IowaScaledEngineering/ckt-xing/mech/ckt-xing-basic-insert v9.stl

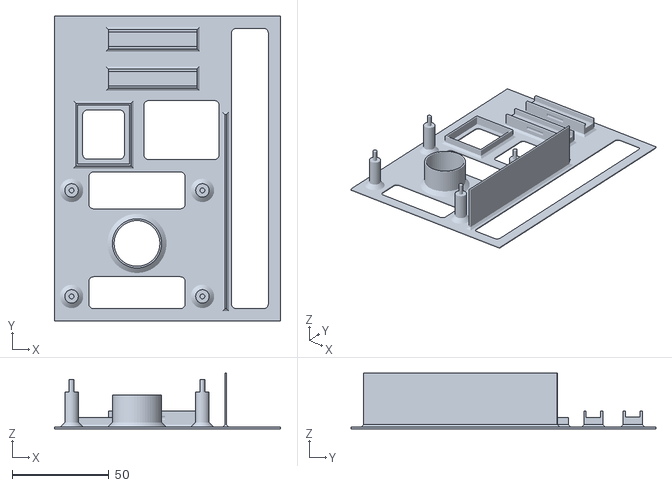
[picture p1: CAD file, 2024-09-25]
mech/ckt-xing-basic-insert v9.stl
116.8 x 157.5 x 28.8
