IowaScaledEngineering/ckt-xing/pg/ckt-xing-tester-v1.0-192aa89/ckt-xing-tester.pdf

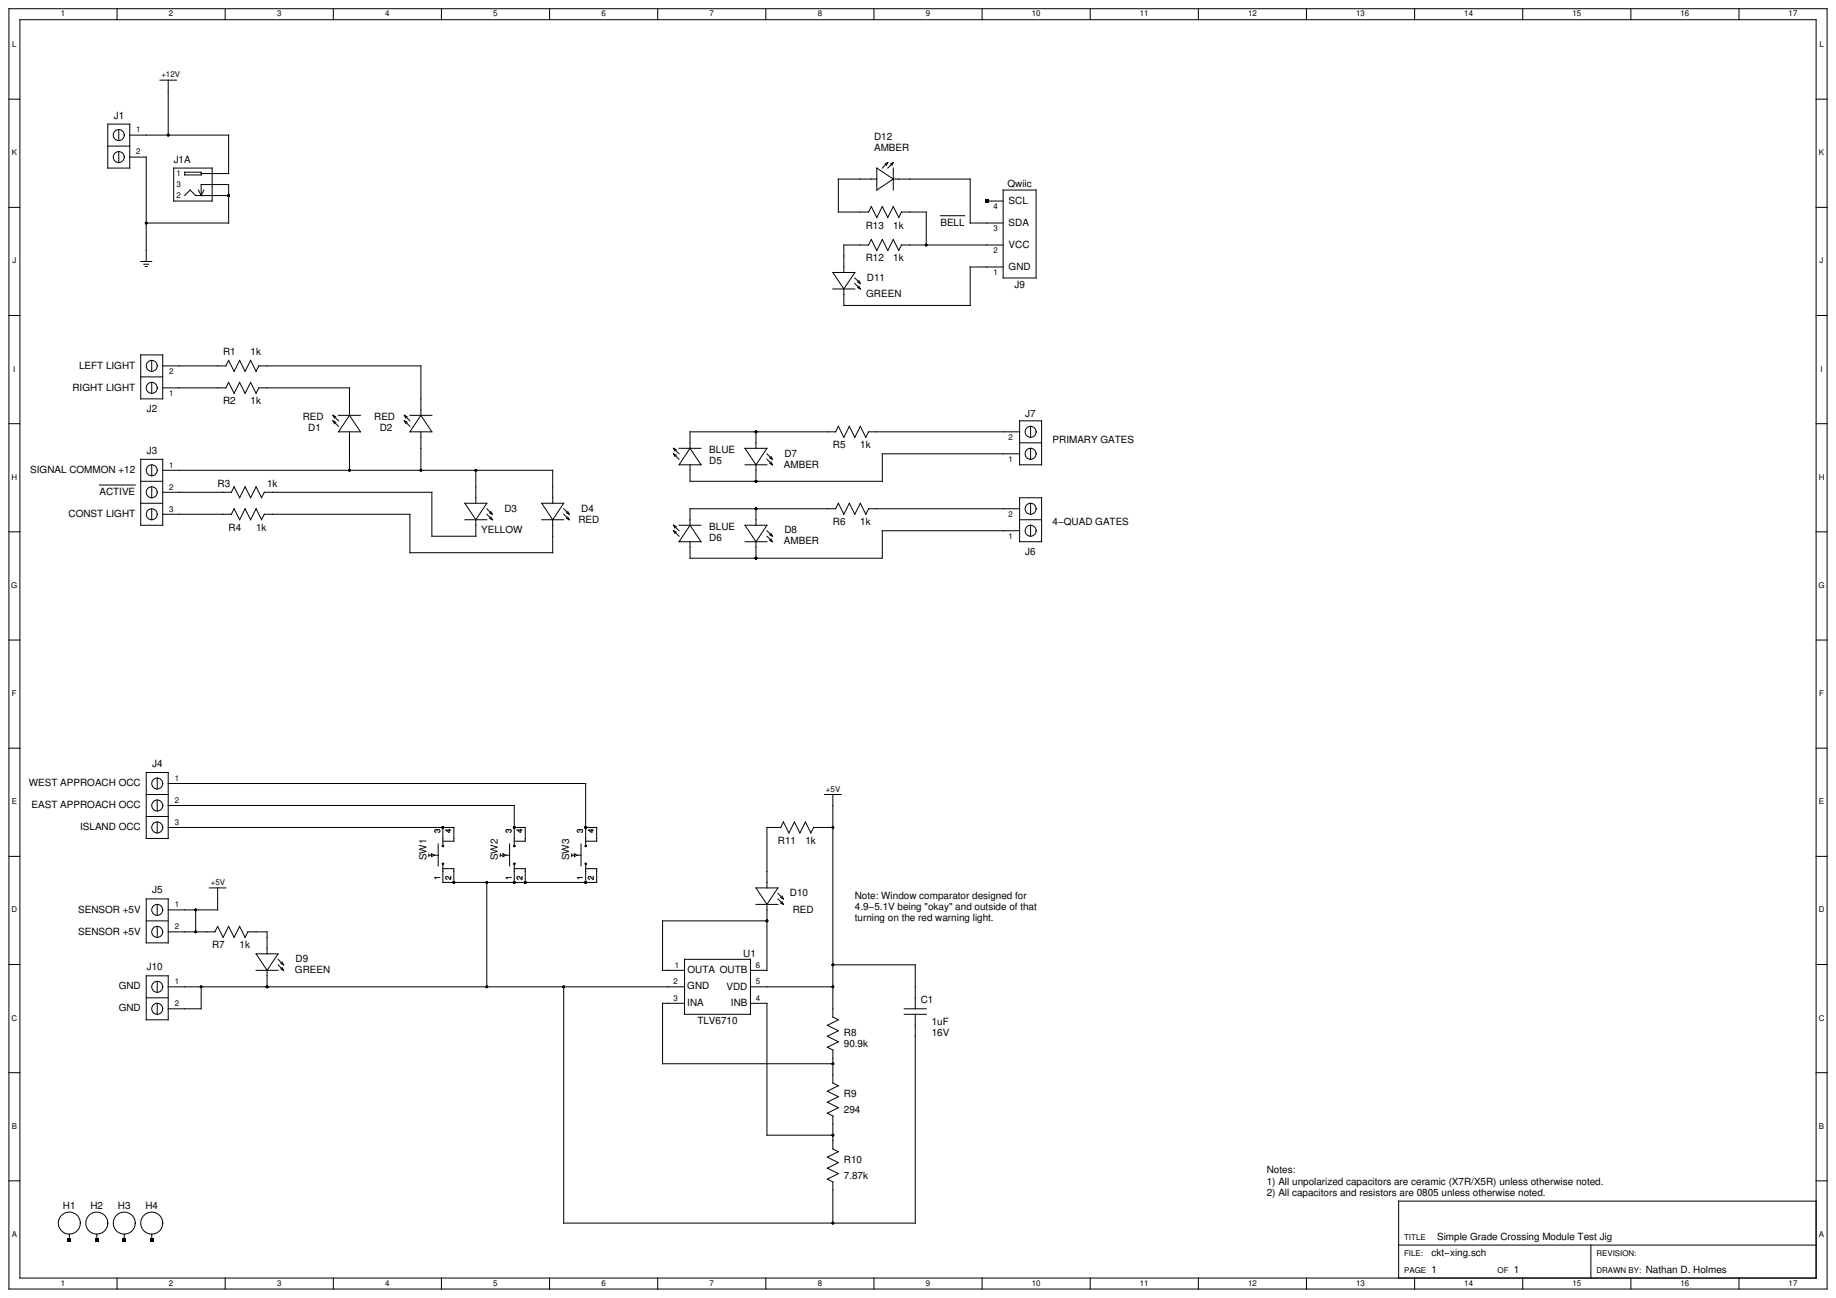
[picture p11: page 1]

Note: Window comparator designed for
4.9−5.1V being "okay" and outside of that
turning on the red warning light.

Notes:
1) All unpolarized capacitors are ceramic (X7R/X5R) unless otherwise noted.
2) All capacitors and resistors are 0805 unless otherwise noted.

Simple Grade Crossing Module Test Jig
ckt−xing.sch
