IowaScaledEngineering/ckt-xing/pg/ckt-xing-adv-v1.0-cd81ae9/ckt-xing-adv.pdf

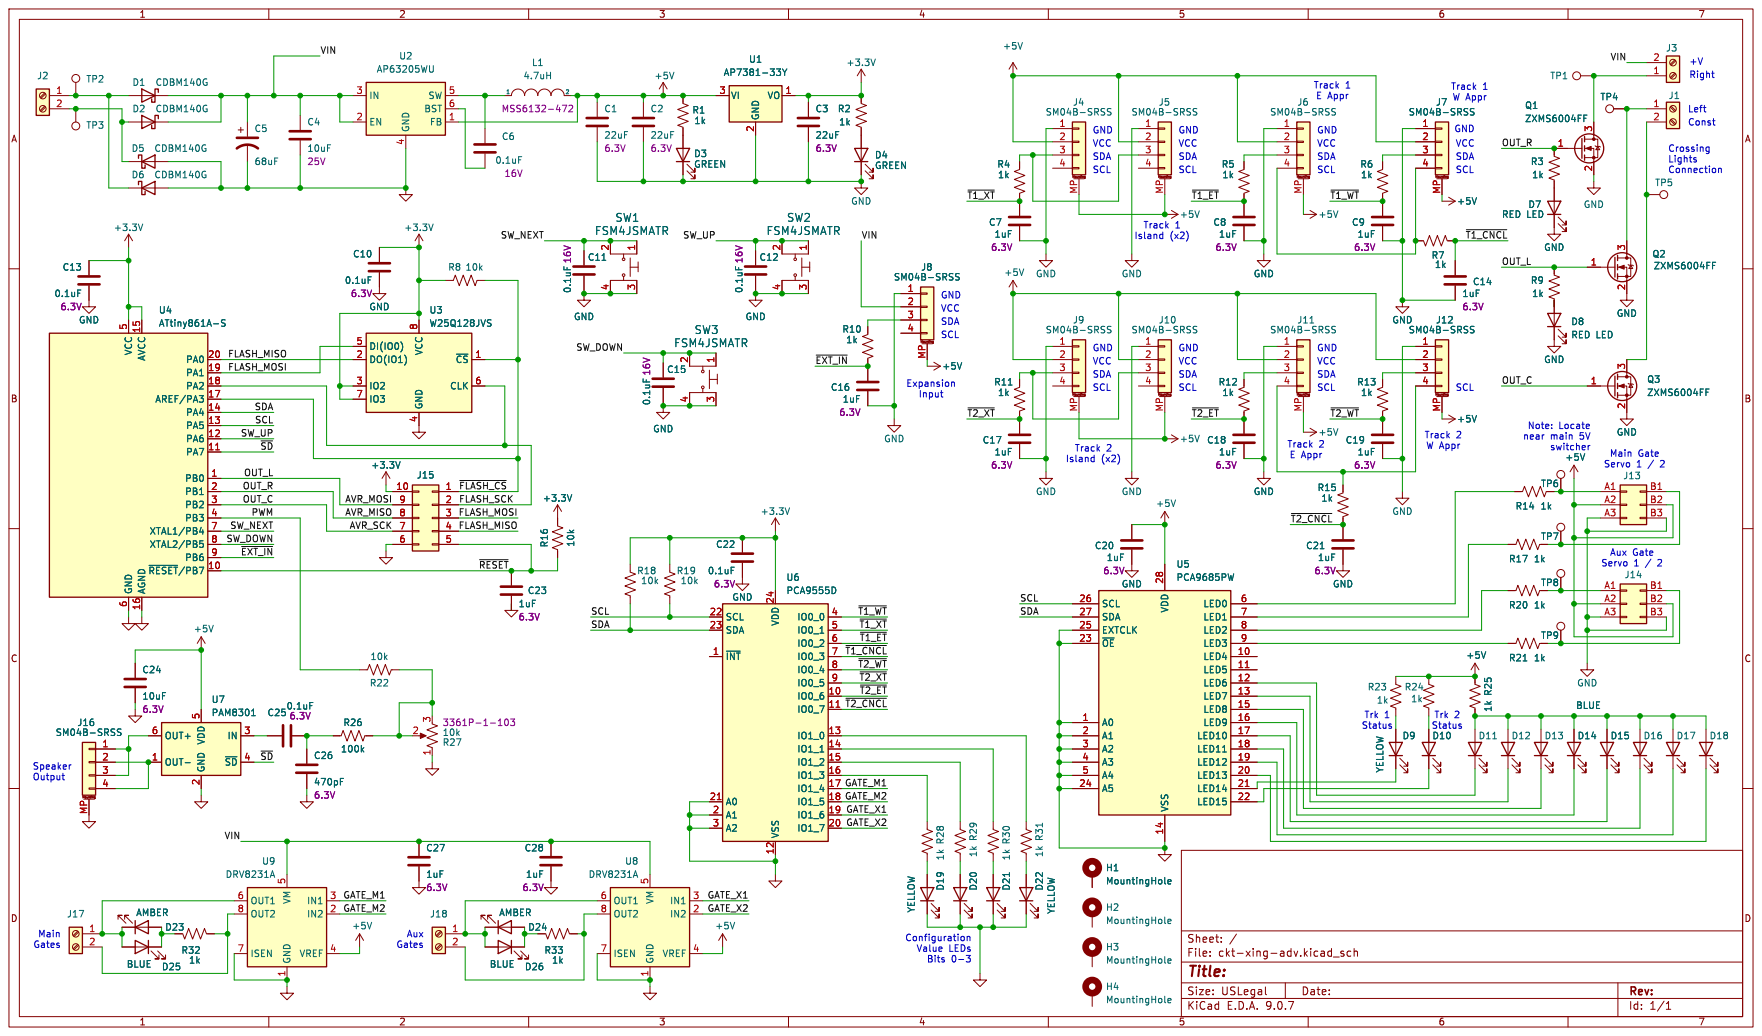
[picture p12: page 1]

Aux Gate Servo 1 / 2 SCL VCC

6 AVCC 15 AGND 16 PA0 20 PA1 19 PA2 18 AREF/PA3 17 PA4 14 PA5 13 PA6 12 PA7 11 PB0 1 PB1 2 PB2 3 PB3 4 XTAL1/PB4 7 XTAL2/PB5 8 PB6 9 ~{RESET}/PB710 U4ATtiny861A-S

Expansion
Trk 1 Status SCL Configuration Value LEDs Bits 0-3

Id: 1/1 Title: File: ckt-xing-adv.kicad_sch Sheet: /
