IowaScaledEngineering/ckt-xing/pg/ckt-xing-basic-v1.1-d01540c/ckt-xing-basic.pdf

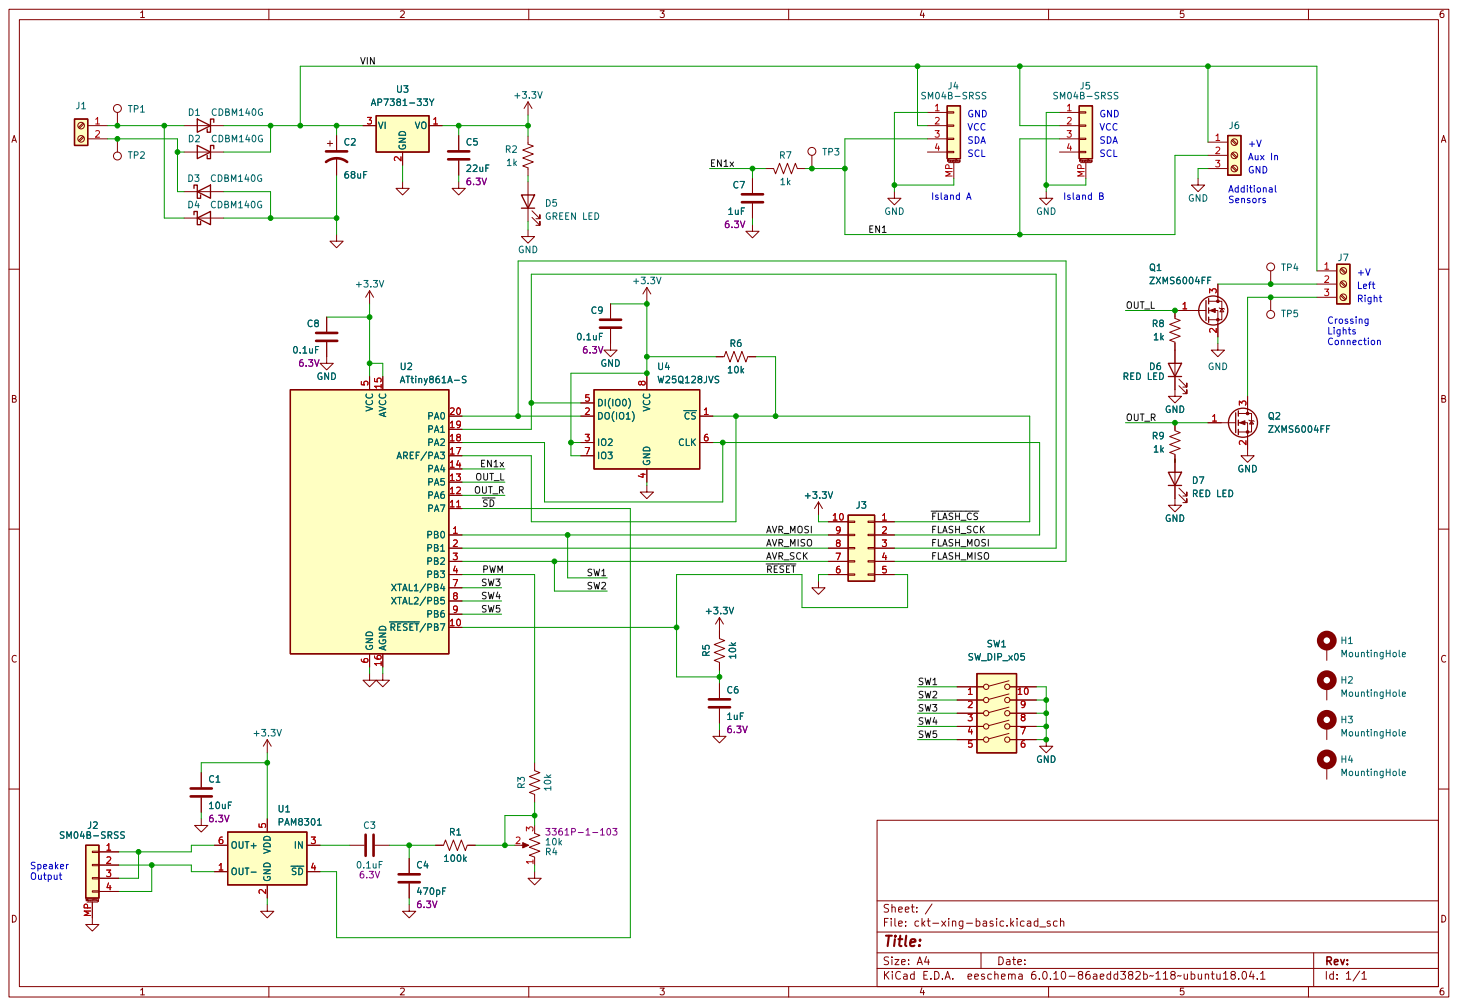
[picture p14: page 1]

AVR_MISO 8 8 | 3 3

PWM
