IowaScaledEngineering/ckt-xing/pg/ckt-xing-txm-v1.0-6521851/ckt-xing-txm.pdf

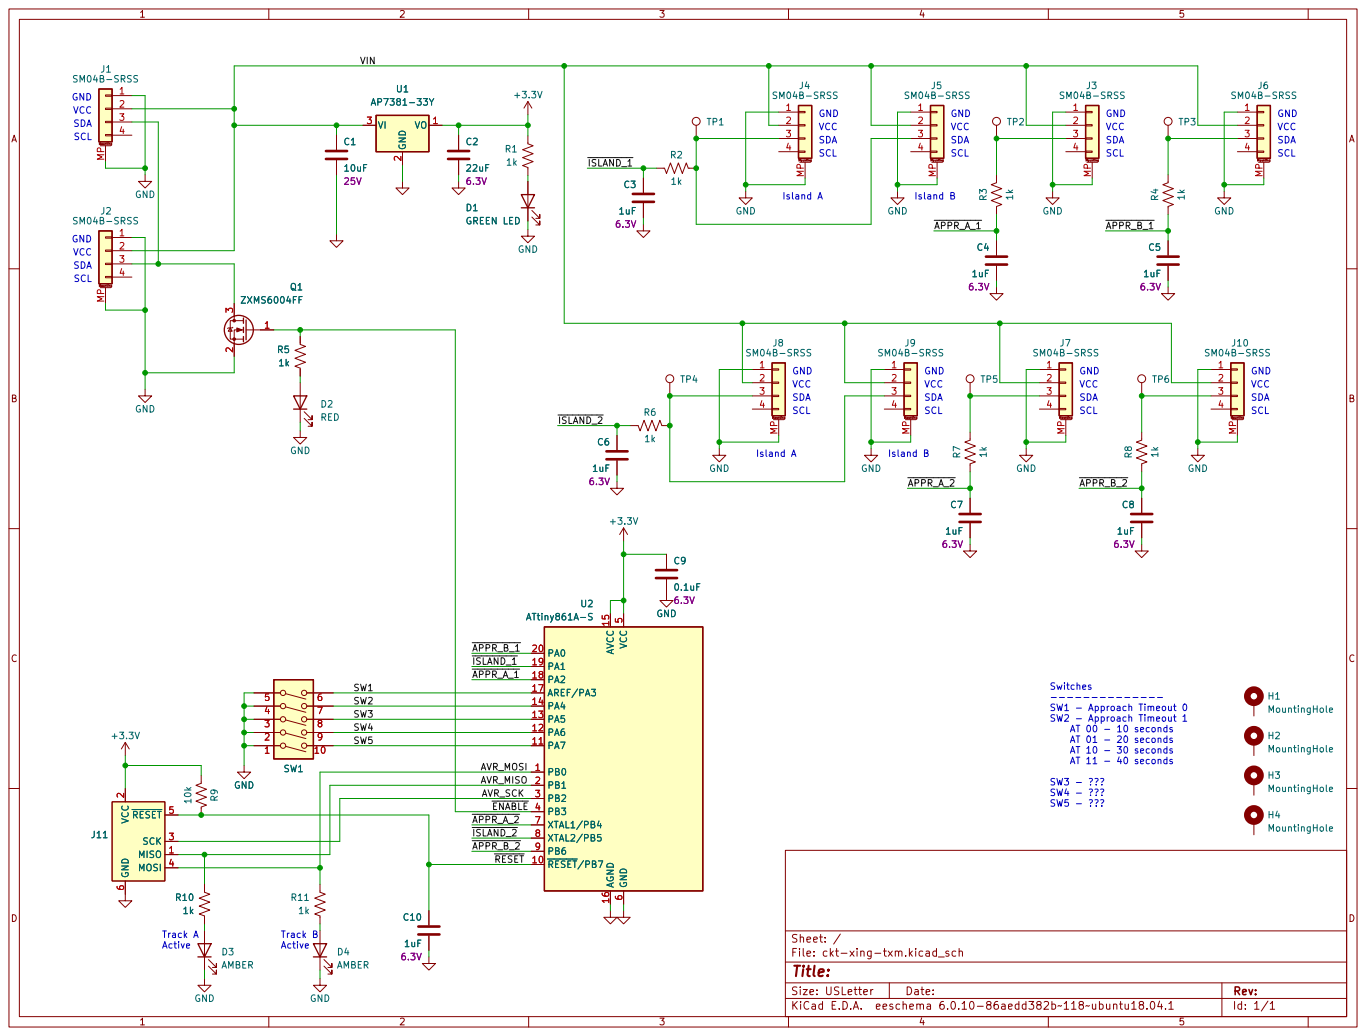
[picture p15: page 1]

2 SCK 3 MOSI 4 ~{RESET} 5 GND

File: ckt-xing-txm.kicad_sch Sheet: /
