IowaScaledEngineering/ckt-xing/pg/ckt-xing-v2.0-f107f7d/ckt-xing-pcb.pdf

# ckt-xing.pcb

# 1. Table of Contents (This Page) Created on Mon Jan 25 11:11:42 2021

# 2. component 3. solder 4. outline 5. plated-drill 6. componentmask 7. soldermask 8. topsilk 9. bottomsilk 10. toppaste 11. topassembly 12. bottomassembly 13. fab

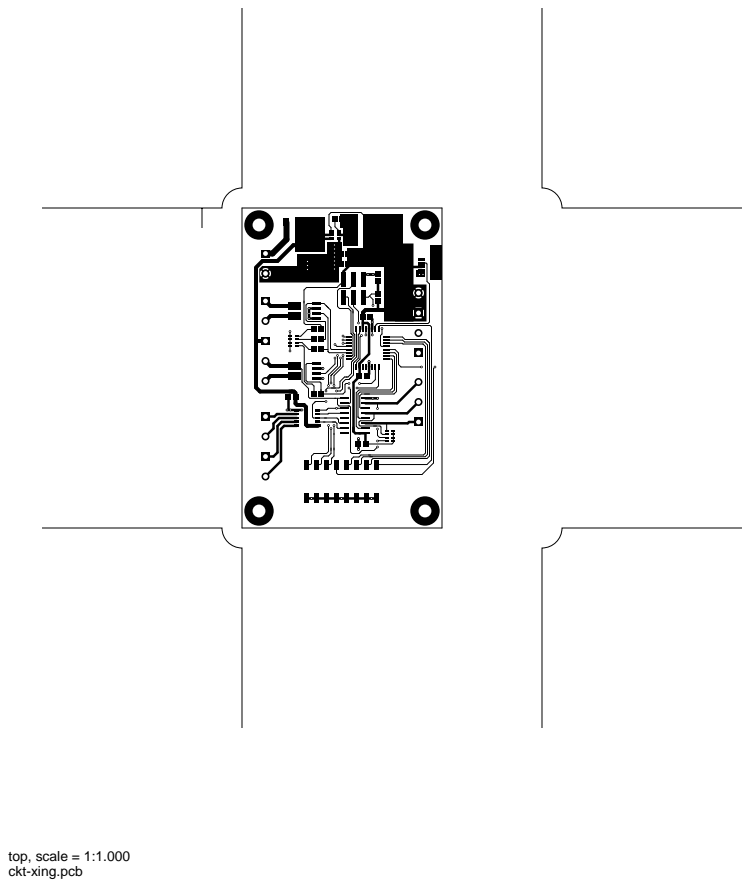
[picture p16: page 2]
top, scale = 1:1.000

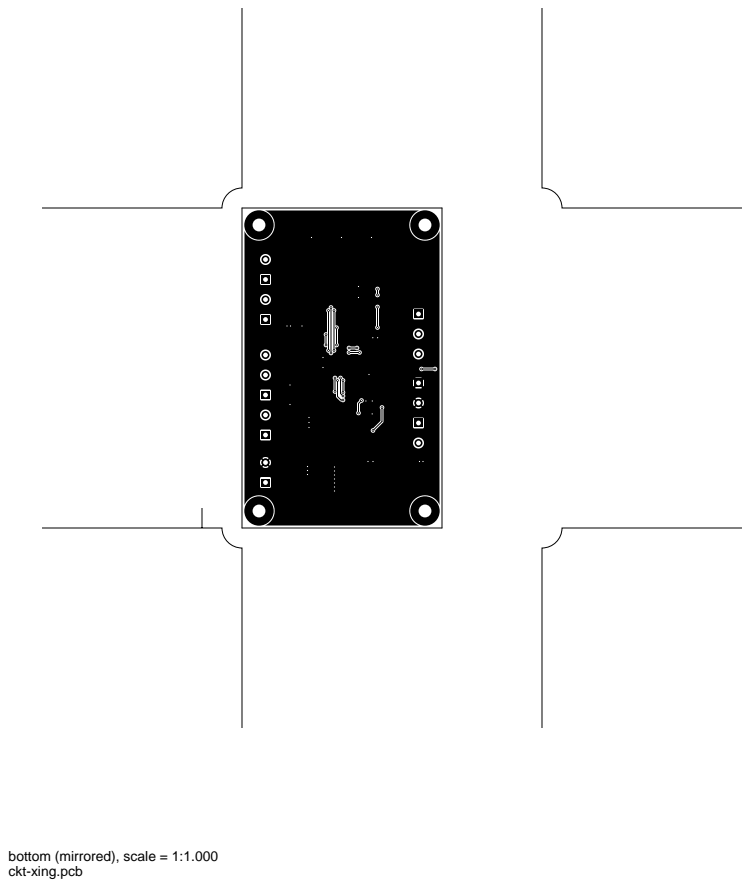
[picture p17: page 3]

bottom (mirrored), scale = 1:1.000

outline, scale = 1:1.000

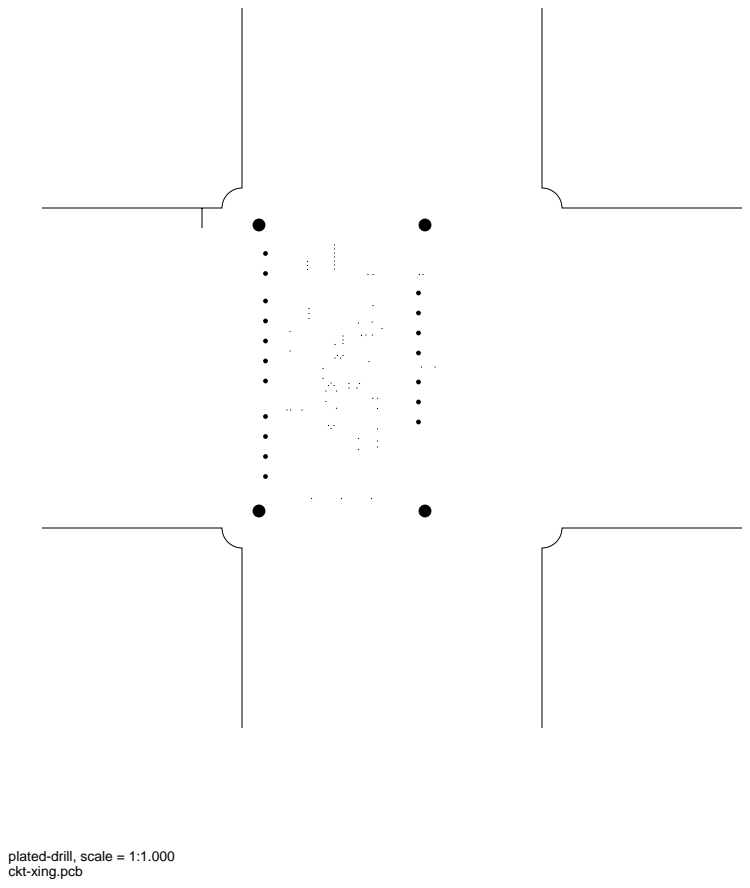
[picture p18: page 5]

plated-drill, scale = 1:1.000

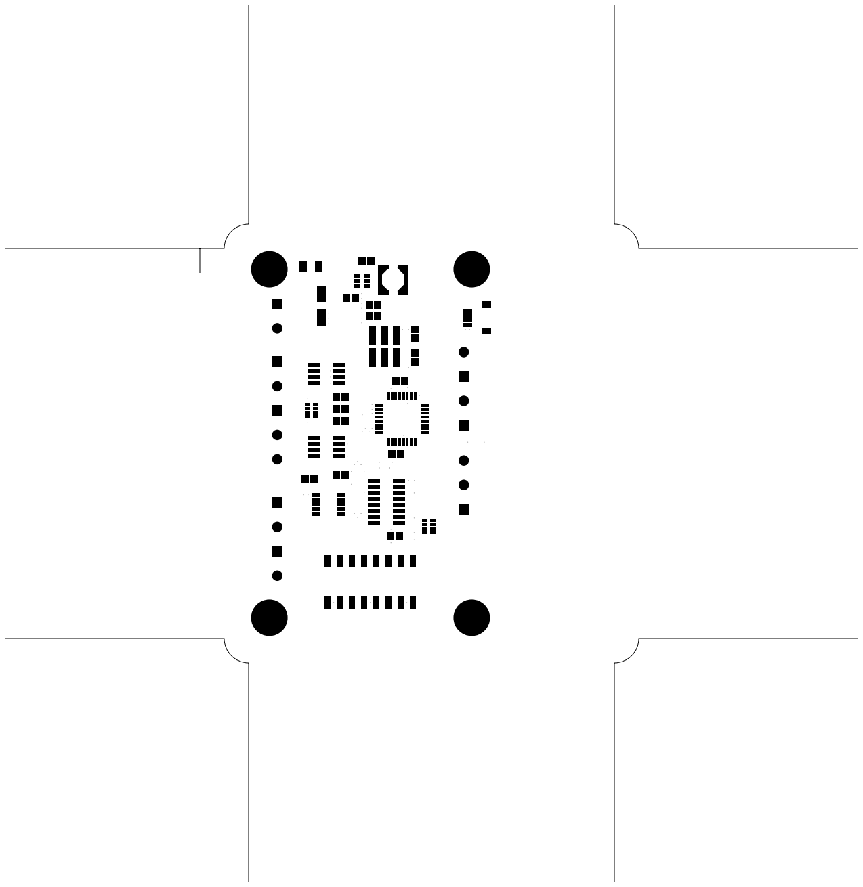
[picture p19: figure]

topmask, scale = 1:1.000

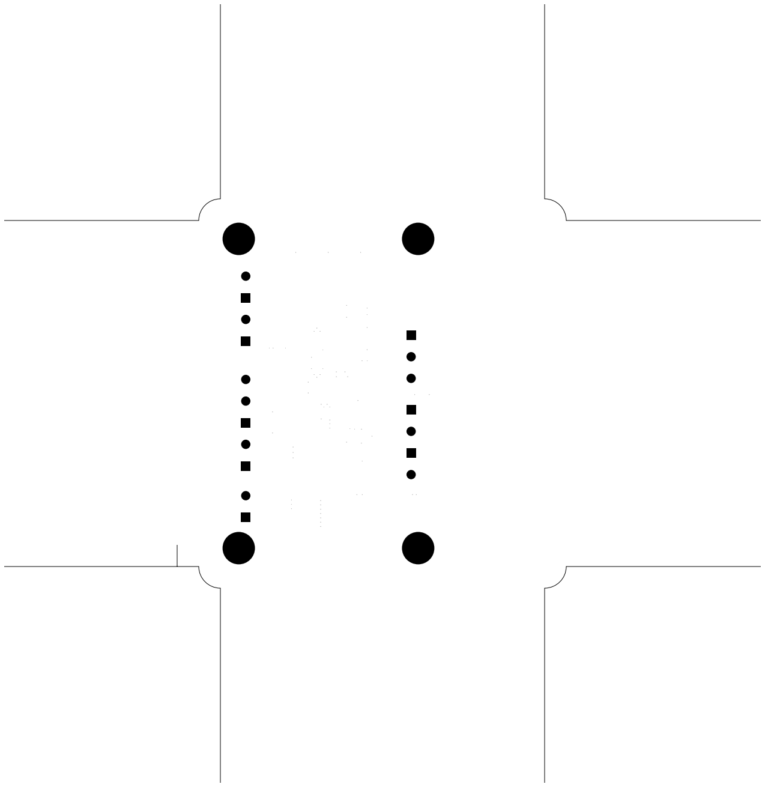
[picture p20: figure]

bottommask (mirrored), scale = 1:1.000

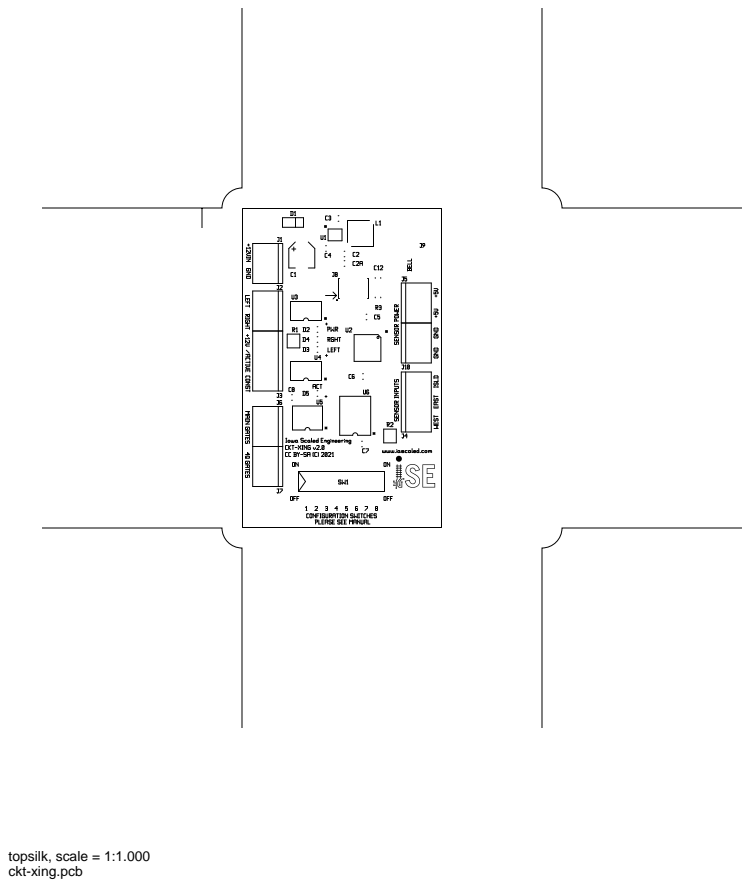
[picture p21: page 8]
topsilk, scale = 1:1.000

bottomsilk (mirrored), scale = 1:1.000

toppaste, scale = 1:1.000

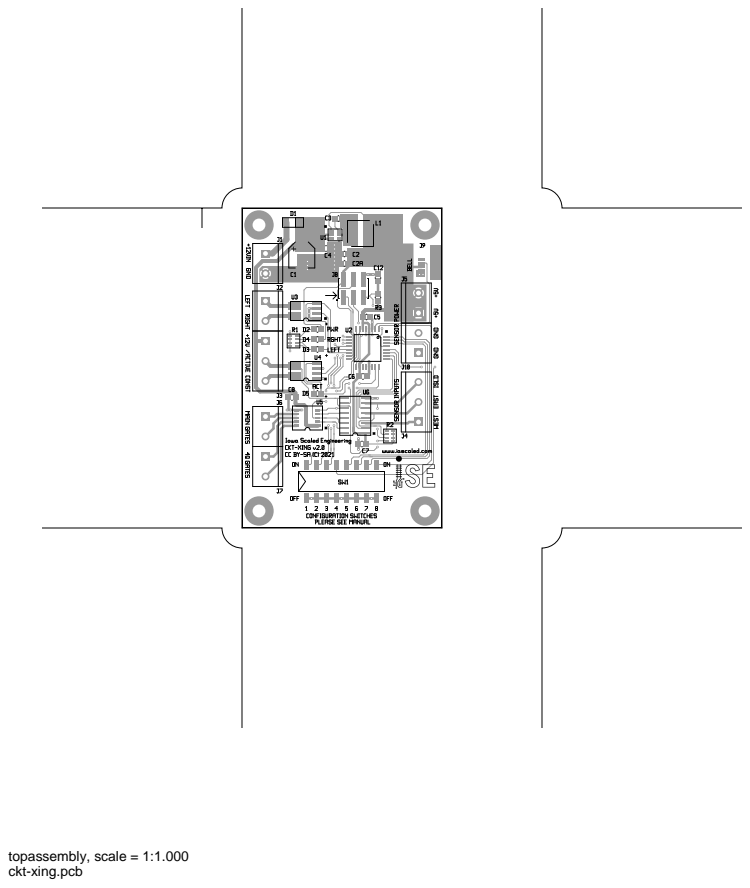
[picture p22: page 11]
topassembly, scale = 1:1.000

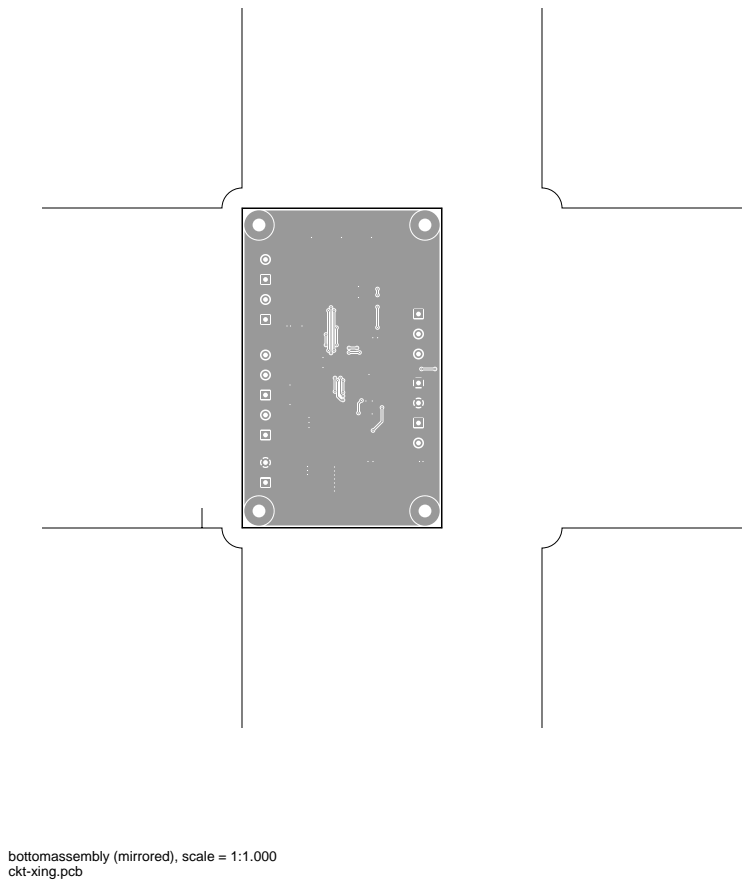
[picture p23: page 12]

bottomassembly (mirrored), scale = 1:1.000

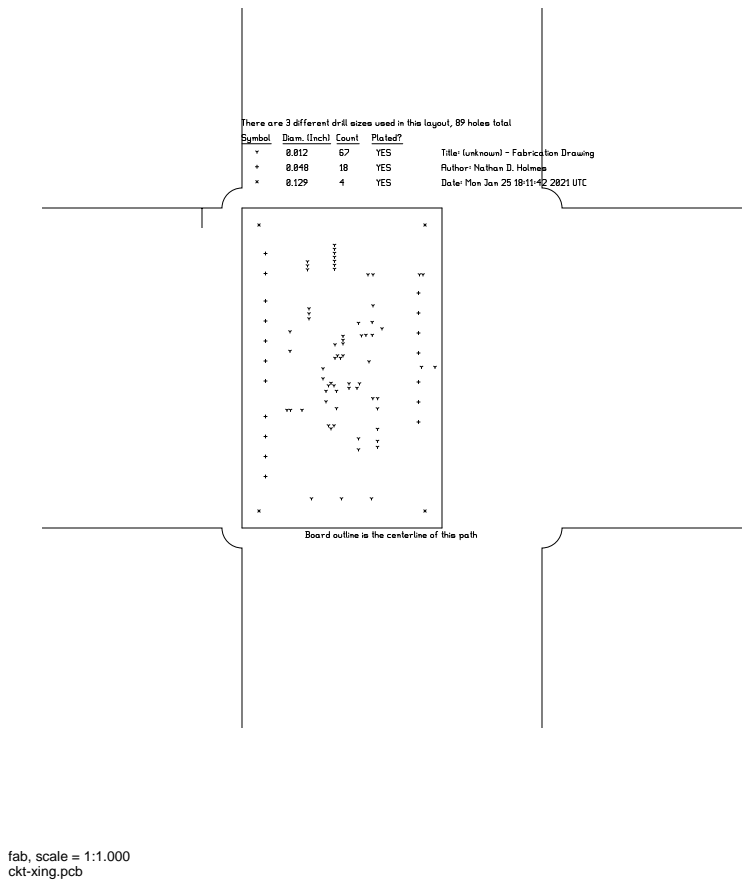
[picture p24: page 13]
fab, scale = 1:1.000
