IowaScaledEngineering/ckt-xing/pg/ckt-xing-basic-v1.0-3cd88d7/ckt-xing-basic.pdf

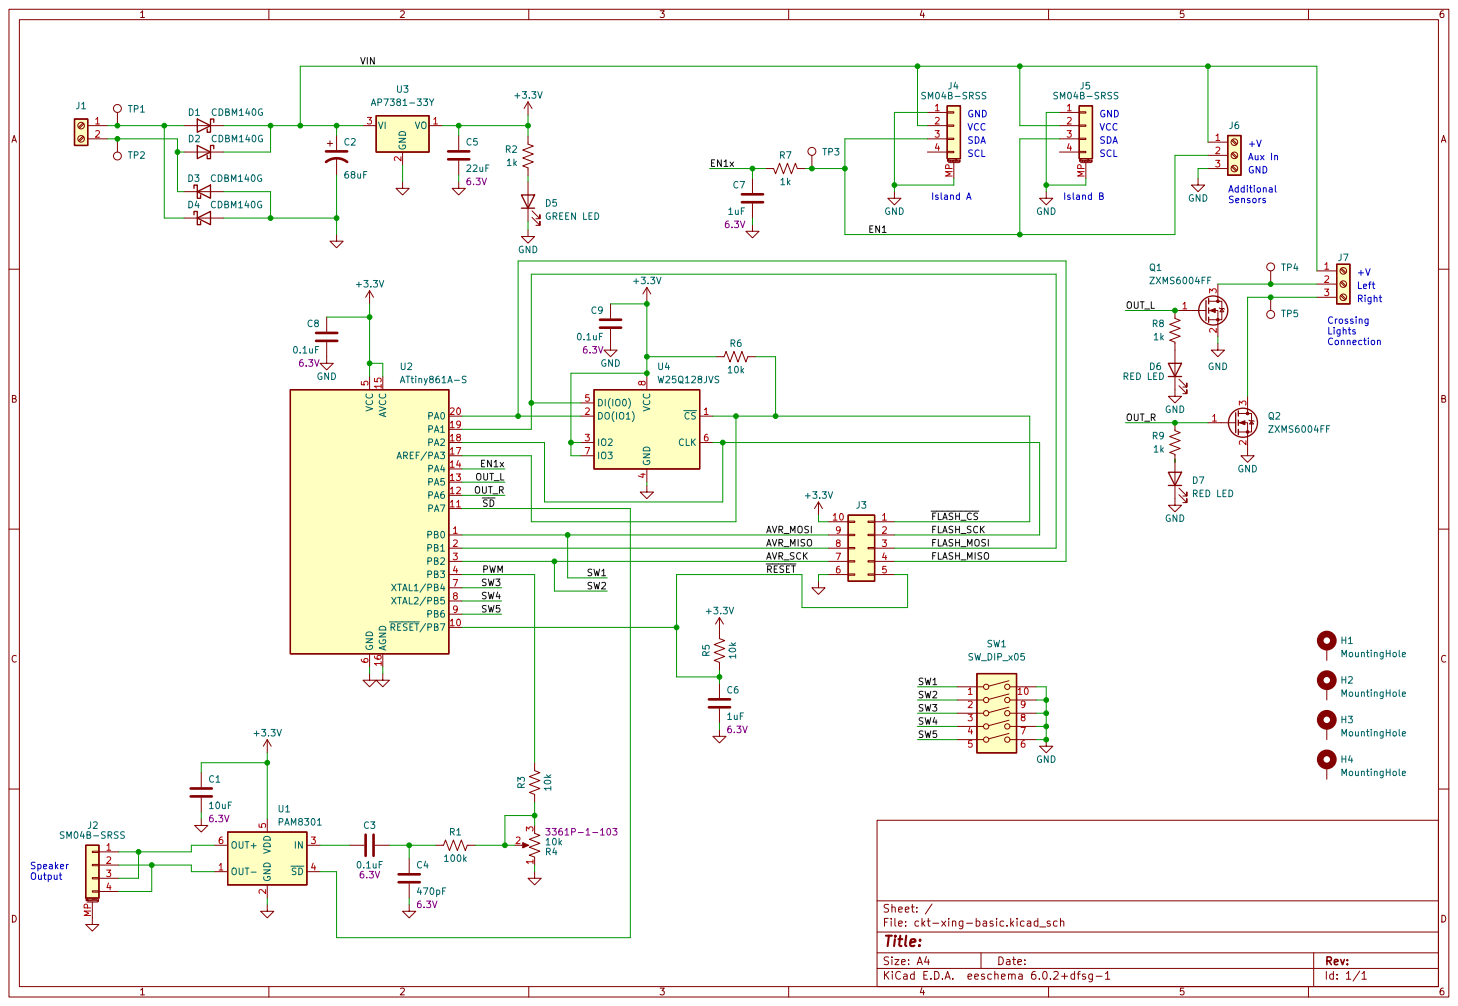
[picture p25: page 1]

AVR_MISO 8 | 3

PWM

File: ckt-xing-basic.kicad_sch Sheet: /
Id: 1/1 Title:
