IowaScaledEngineering/ckt-xing/(commit log)

2019-10-11 Initial cut of crossing code
2019-10-14 Add ADC reading on 0/1 to get time delays (not yet used)
2019-10-14 Schematic up to this point
    [ckt-xing.sch]
2019-10-24 Revise schematic to add logic level inputs and protection strutures, along with gate motor drivers
    [ckt-xing.sch]
2019-10-24 Revert 2-pk R10 back to separate resistors
    [ckt-xing.sch]
2020-04-27 Add symbols and start of schematic for ARM SAMD21 port
    [ckt-xing.sch]
2020-04-27 Update schematic with 4049 buffer for input lines
    [ckt-xing.sch]
2020-04-27 Add footprints to processor and JTAG/SWD header and correct part number on processor
    [ckt-xing.sch]
2020-04-28 Bad DMN symbol meant the part was backwards in the schematic. Oops.
    [ckt-xing.sch]
2020-04-28 Revert "Bad DMN symbol meant the part was backwards in the schematic. Oops."
    This reverts commit 0f5f286c5c37fd099875a0acff5689213a8e55fb.
    [ckt-xing.sch]
2020-04-28 Fix DMN for good
    [ckt-xing.sch]
2020-04-30 Schematic, second time through finalizing it all.
    [ckt-xing.sch]
2020-05-01 Initial cut of PCB
    [ckt-xing.pcb, ckt-xing.sch]
2020-05-01 Fix silk problem on jtag header
    [ckt-xing.pcb]
2020-05-01 Fix /XIN text
    [ckt-xing.pcb]
2020-07-01 Add + to diodes, add boilerplate text
    [ckt-xing.pcb]
2020-07-01 Add pg 1.0 of the arm version
    [ckt-xing.bottom.gbr, ckt-xing.bottommask.gbr, ckt-xing.bottompaste.gbr, ckt-xing.bottomsilk.gbr, ckt-xing.fab.gbr, ckt-xing.outline.gbr, ckt-xing.top.gbr, ckt-xing.topmask.gbr]
2021-01-12 Move back to an AVR and external bell
    [ckt-xing.sch]
2021-01-21 Initial cut of v2 PCB
    [ckt-xing.pcb, ckt-xing.sch]
2021-01-21 Move J9 to board edge, fix /ACTIVE and CONST labels
    [ckt-xing.pcb, ckt-xing.sch]
2021-01-21 Add ISE logo, change ISLD to ISLAND
    [ckt-xing.pcb]
2021-01-25 PG of AVR-based v2.0
    [ckt-xing.bottom.gbr, ckt-xing.bottommask.gbr, ckt-xing.bottompaste.gbr, ckt-xing.bottomsilk.gbr, ckt-xing.fab.gbr, ckt-xing.outline.gbr, ckt-xing.top.gbr, ckt-xing.topmask.gbr]
2021-02-04 Initial cut of things that appears to work
2021-02-10 Start of the testing jig
    [ckt-xing-tester.pcb, ckt-xing-tester.sch]
2021-02-10 ckt-xing-tester - change hole sizes for pogos
    [ckt-xing-tester.pcb]
2021-02-10 Add power good window comp to tester Move barrel jack
    [ckt-xing-tester.pcb, ckt-xing-tester.sch]
2021-02-12 Add bell test connector to test module Fix board outline issue
    [ckt-xing-tester.pcb, ckt-xing-tester.sch]
2021-02-22 PG the xing test board
    [ckt-xing-tester.bottom.gbr, ckt-xing-tester.bottommask.gbr, ckt-xing-tester.bottompaste.gbr, ckt-xing-tester.bottomsilk.gbr, ckt-xing-tester.fab.gbr, ckt-xing-tester.outline.gbr, ckt-xing-tester.top.gbr, ckt-xing-tester.topmask.gbr]
2023-07-05 Start of a new version to improve manufacturability and decrease cost
    [ckt-xing.sch]
2024-03-25 Start of basic crossing controller
    [ckt-xing-basic.kicad_pcb, ckt-xing-basic.kicad_sch]
2024-03-25 Forgot to add holes and a few test points
    [ckt-xing-basic.kicad_sch]
2024-04-01 First cut at ckt-xing-basic board layout
    [ckt-xing-basic.kicad_pcb, ckt-xing-basic.kicad_sch]
2024-04-02 Various fixes
    [ckt-xing-basic.kicad_pcb]
2024-04-02 Fix 3D model for 3 position block and remove thermals on C5
    [ckt-xing-basic.kicad_pcb]
2024-04-03 Add more space, because MDP wants more space...
    [ckt-xing-basic.kicad_pcb]
2024-04-03 Move some text around, update copyright to 2024, not 2004
    [ckt-xing-basic.kicad_pcb]
2024-04-03 Tweaked text
    [ckt-xing-basic.kicad_pcb]
2024-04-03 More text tweaks
    [ckt-xing-basic.kicad_pcb]
2024-04-04 Turn 3 position terminal blocks so that pin 1 is on the left
    [ckt-xing-basic.kicad_pcb, ckt-xing-basic.kicad_sch]
2024-04-06 Fixed DRC
    [ckt-xing-basic.kicad_pcb]
2024-04-06 Fixed warning
    [ckt-xing-basic.kicad_pcb]
2024-04-06 Files for fab
    [ckt-xing-basic-NPTH.drl, ckt-xing-basic.drl, ckt-xing-basic.gbl, ckt-xing-basic.gbo, ckt-xing-basic.gbp, ckt-xing-basic.gbr, ckt-xing-basic.gbs, ckt-xing-basic.gm1]
2024-05-23 Remove all the old ckt-xing schematics, pcbs, and artifacts we no longer need
    [ckt-xing-tester.pcb, ckt-xing-tester.sch, ckt-xing.pcb, ckt-xing.sch]
2024-05-23 Add stuff to ignore kicad litter
2024-06-10 Fix issue where millis wasn't being handled safely between the ISR and main code
    [audioAndLights.c, audioAndLights.h, ckt-xing-basic.c]
2024-06-10 Fix the millis comparison so we don't get rollover problems
    [ckt-xing-basic.c]
2024-07-30 Add initial cut of xing pro schematic
    [ckt-xing-pro.kicad_pcb, ckt-xing-pro.kicad_sch]
2024-07-31 Add schematic for track expansion module (additional track predictor)
    [ckt-xing-txm.kicad_pcb, ckt-xing-txm.kicad_sch]
2024-08-01 Add second track inputs to txm
    [ckt-xing-txm.kicad_sch]
2024-08-08 Initial layout of TXM board
    [ckt-xing-txm.kicad_pcb, ckt-xing-txm.kicad_sch]
2024-08-13 Review updates
    [ckt-xing-txm.kicad_pcb]
2024-08-13 Update to have "RoadReady" text and change delay to timeout
    [ckt-xing-basic.kicad_pcb]
2024-08-26 Expand thermal plane around regulator
    [ckt-xing-txm.kicad_pcb]
2024-08-26 Add pg for ckt-xing-basic 1.1 and ckt-xing-txm 1.0
    [ckt-xing-basic-NPTH.drl, ckt-xing-basic.drl, ckt-xing-basic.gbl, ckt-xing-basic.gbo, ckt-xing-basic.gbp, ckt-xing-basic.gbr, ckt-xing-basic.gbs, ckt-xing-basic.gm1]
2024-09-25 Packaging insert for ckt-xing-basic
    [ckt-xing-basic-insert v9.stl]
2024-10-02 Initial cut of TXM firmware
2025-08-13 Updates to put three switches on approach timeout
    [ckt-xing-pro.kicad_sch]
2025-09-21 Update 3d models on the txm
    [ckt-xing-txm.kicad_pcb]
2025-09-21 Rename GC Pro to GC Advanced to avoid colliding with Chuck's naming
    [ckt-xing-adv.kicad_pcb, ckt-xing-adv.kicad_sch]
2026-01-28 New full-featured xing plan
    [ckt-xing-adv.kicad_sch]
2026-03-08 Update advanced crossing with some fixes before PCB layout
    [ckt-xing-adv.kicad_pcb, ckt-xing-adv.kicad_sch]
2026-03-10 All nets routed on the ckt-xing-adv/ckt-xing-adv Still some DRC problems related to kicad 9
    [ckt-xing-adv.kicad_pcb, ckt-xing-adv.kicad_sch]
2026-03-12 Updates to the big crossing - fix some actual DRC issues
    [ckt-xing-adv.kicad_pcb]
2026-03-16 Add test points for servo outputs Feedback from Michael on text position, etc
    [ckt-xing-adv.kicad_pcb, ckt-xing-adv.kicad_sch]
2026-03-18 Fix/ignore some DRCs
    [ckt-xing-adv.kicad_pcb]
2026-04-13 Working-ish initial code for ckt-xing-adv
    [configuration.h]
2026-04-13 Status LEDs working correctly
    [ckt-xing-adv.c, systemHardware.c, systemHardware.h, xingSignals.c, xingSignals.h]
2026-04-13 Factory reset works
    [configuration.h]
2026-04-13 Change some defaults Refactor configuration loading Make led/lamp work
    [configuration.h]
2026-04-13 Fix issue with crossing state timer
    [xingSignals.c]
2026-04-13 Get rid of long press on the servos
2026-04-13 Fix servo issue where if down was > up, things spazzed out
    [systemHardware.c]
2026-04-13 System test mode now works
    [configuration.h]
2026-04-14 Update to v1.1, adding level shifters between the CPU and the 9685, since it's in the 5V domain
    [ckt-xing-adv.kicad_pcb, ckt-xing-adv.kicad_sch]
2026-04-16 Make track lights work in diag mode
2026-04-16 Fix issue with track status light pulsing
    [systemHardware.c]
2026-05-03 Add electrolytic to servo drivers
    [ckt-xing-adv.kicad_pcb, ckt-xing-adv.kicad_sch]
2026-05-29 Cleanup on adv
    [ckt-xing-adv.kicad_pcb]
2026-06-17 Actually use island timeout, make factory reset put the up/down state of the servos in the same position, and remove a fixme that was fixed
    [configuration.c, crossingTrack.c]
2026-06-17 Some stuff to improve servo jitter
    [ckt-xing-adv.c, systemHardware.c, systemHardware.h]
2026-06-19 PG 1.0 and 1.1
    [ckt-xing-adv-NPTH.drl, ckt-xing-adv.drl, ckt-xing-adv.gbl, ckt-xing-adv.gbo, ckt-xing-adv.gbp, ckt-xing-adv.gbr, ckt-xing-adv.gbs, ckt-xing-adv.gm1]
2026-10-10 Place limits on up/down switches to not get servo values massively out of range
2026-10-10 Reverse main/aux gates definitions for the motor drives - they're backwards
2026-10-10 Rolled spi clock toggle into a loop to save some space, doesn't seem to impact playback at bell rates
2026-10-10 Change millis to a uint16_t to get rid of some of the uint32_t functions and save code space. Still more than adequate for this thing.
2026-10-10 Blank the configuration lines while NEXT button is being held down. This was confusing when going to save configuration options, as it would move to the next item and change the lights that you'd jus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
