IowaScaledEngineering/ckt-xing/(notices)

Notices in the files:
kicad/ckt-xing-basic/ckt-xing-basic.kicad_pcb:
CC BY-SA ©2024
kicad/ckt-xing-txm/ckt-xing-txm.kicad_pcb:
v1.0 CC BY-SA
©2024
kicad/ckt-xing-adv/ckt-xing-adv.kicad_pcb:
CC BY-SA ©2026
